dplumly/Zombie_Selfie/img/hand.jpg

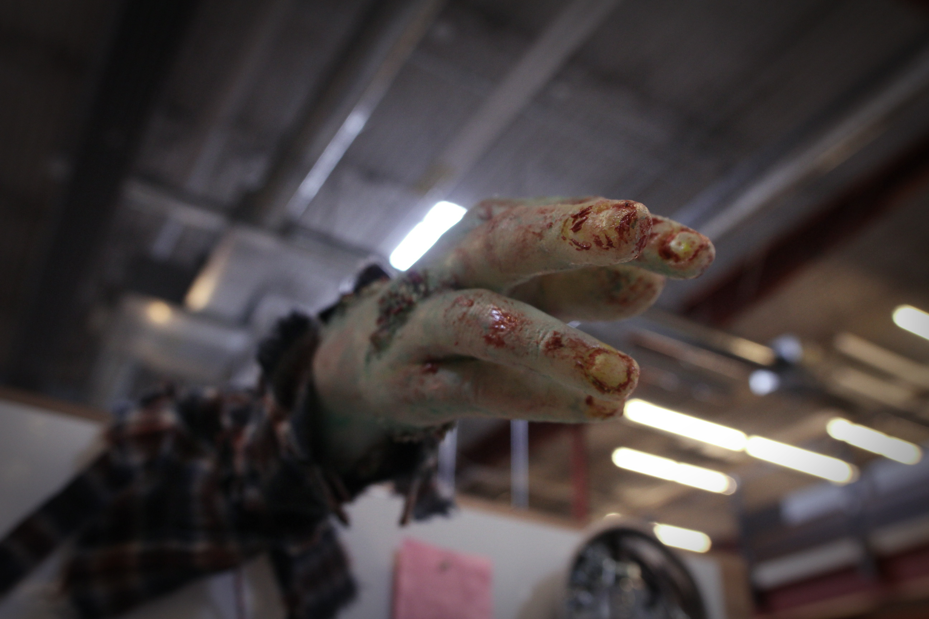
img/hand.jpg
