dplumly/Zombie_Selfie/img/build.jpg

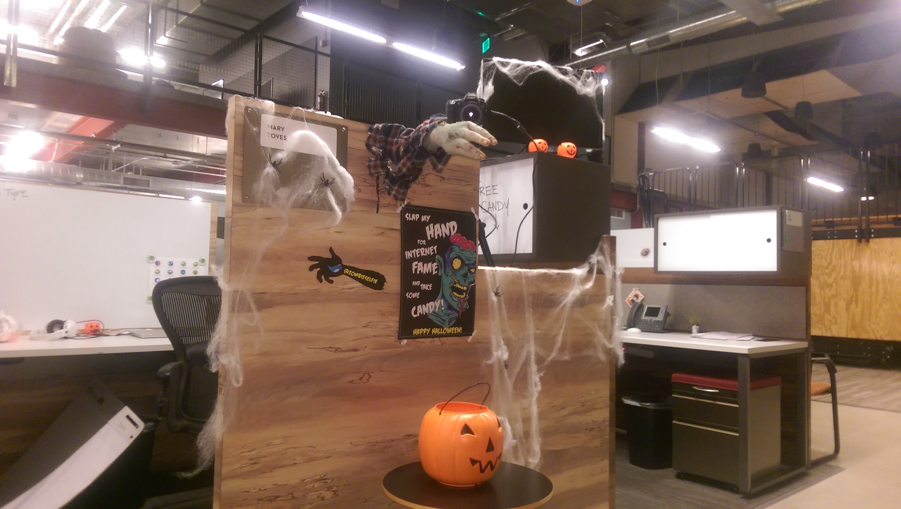
img/build.jpg
